gordonatgithub/arduino-fan-controller/(commit log)

2022-09-06 Updated modified TFT display driver to move source of D1/D0 pins. On Leonardo the D1/D0 pins originally mapped to D3/D2, but due to pin conflict move them to D1/D0.
2022-10-06 Update with new fan. Noctua fans were too load inside cabinet, switched to "be quiet! Silent Wings 3 140mm PWM, BL067" which were signficantly quieter but as side effect also decreased cooling (tempe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
